gmaxdragon/Modular-Pi-Hat/BOM.md

# Modular PI HAT – bill of materials

<!-- Generated by Half Life from project cmuxmr025006j01ng1djt318e. Edits here are overwritten on the next sync. -->
<!-- Generated: 2026-10-12T02:13:04.104Z -->

> [!NOTE]
> This parts list is mirrored from [Half Life](https://halflife.hackclub.com). Editing it here will not change the platform's copy, and the next sync overwrites this file.

| Week | Tier | Parts funding |
| --- | --- | --- |
| Week 1 | Tier 3 | $100.00 |

| Part | What it's for | Qty | Unit | Total | Vendor |
| --- | --- | --- | --- | --- | --- |
| [ESP32-S3-WROOM-1-N8R8 module, 8MB flash + 8MB PSRAM](https://www.mouser.com/en/ProductDetail/Espressif-Systems/ESP32-S3-WROOM-1-N8R8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) | MAIN U2. Exact manufacturer part ESP32-S3-WROOM-1-N8R8: 8MB flash, 8MB PSRAM and PCB antenna. Mouser ordering number 356-EP32S3WROOM1N8R8. Purchase one bare SMD module from Mouser, not N8 or 1U varian | 1 | $6.28 | $6.28 | [Mouser](https://www.mouser.com/en/ProductDetail/Espressif-Systems/ESP32-S3-WROOM-1-N8R8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) |
| [AP2112K-3.3 3.3 V LDO regulator](https://www.digikey.com/en/products/detail/diodes-incorporated/AP2112K-3-3TRG1/4470746) | U3; verify thermal/load budget before making PCB or operating expansion ports. | 1 | $0.28 | $0.28 | [DigiKey](https://www.digikey.com/en/products/detail/diodes-incorporated/AP2112K-3-3TRG1/4470746) |
| [40-pin extra-tall 2x20 female stacking header](https://www.digikey.com/en/products/detail/adafruit-industries-llc/1979/6238003) | J1 bottom-side socket; verify actual bottom-mounting orientation, pin fit, Pi/Fusion HAT clearance. | 1 | $2.95 | $2.95 | [DigiKey](https://www.digikey.com/en/products/detail/adafruit-industries-llc/1979/6238003) |
| [4-way 5.08 mm Phoenix screw terminal](https://www.digikey.com/en/products/detail/phoenix-contact/1715747/260633) | One terminal on main J11 and one on extender J1. Verify housing/cable exit. | 2 | $2.28 | $4.56 | [DigiKey](https://www.digikey.com/en/products/detail/phoenix-contact/1715747/260633) |
| [2-way 5.08 mm Phoenix screw terminal](https://www.digikey.com/en/products/detail/phoenix-contact/1715721/260631) | J9 external servo power input. Verify exact terminal dimensions. | 1 | $1.16 | $1.16 | [DigiKey](https://www.digikey.com/en/products/detail/phoenix-contact/1715721/260631) |
| [Breakaway 0.1 inch male pin header strips, 10-pack](https://www.digikey.com/en/products/detail/adafruit-industries-llc/392/21283800) | Cut four 6-pin headers for MAIN J4 J5 J6 J7, five 3-pin headers for MAIN J2 J3 J12 and EXT J2 J3, plus four male pins for OLED; one ten-strip 36-pin pack covers all 43 physical pins. | 1 | $4.95 | $4.95 | [DigiKey](https://www.digikey.com/en/products/detail/adafruit-industries-llc/392/21283800) |
| [USB-C USB2.0 receptacle](https://www.digikey.com/en/products/detail/gct/USB4105-GF-A/11198441) | J8: custom land pattern; compare connector drawing and approve solderability. | 1 | $0.80 | $0.80 | [DigiKey](https://www.digikey.com/en/products/detail/gct/USB4105-GF-A/11198441) |
| [470 uF 10 V through-hole capacitor](https://www.digikey.com/en/products/detail/panasonic-industry/EEU-FR1A471/9921021) | C3; polarized. Match 8.0 mm body, 3.50 mm pitch, lead drill. | 1 | $0.71 | $0.71 | [DigiKey](https://www.digikey.com/en/products/detail/panasonic-industry/EEU-FR1A471/9921021) |
| [100 uF 25 V through-hole capacitor](https://www.digikey.com/en/products/detail/kyocera-avx/RPA0609101M025B/17634433) | C1; polarized. Extender actual footprint 6.3 mm body, 2.50 mm pitch. Verify lead and polarity. | 1 | $0.87 | $0.87 | [DigiKey](https://www.digikey.com/en/products/detail/kyocera-avx/RPA0609101M025B/17634433) |
| [22 uF 10 V 1206 ceramic capacitor](https://www.digikey.com/en/products/detail/samsung-electro-mechanics/CL31A226KPHNNNE/3886945) | C4; effective capacitance at 3.3 V bias pending. | 1 | $0.47 | $0.47 | [DigiKey](https://www.digikey.com/en/products/detail/samsung-electro-mechanics/CL31A226KPHNNNE/3886945) |
| [1 uF 50 V 0805 ceramic capacitor](https://www.digikey.com/en/products/detail/samsung-electro-mechanics/CL21A105KBCLNNC/3888054) | C2 C7 C8. | 3 | $0.18 | $0.54 | [DigiKey](https://www.digikey.com/en/products/detail/samsung-electro-mechanics/CL21A105KBCLNNC/3888054) |
| [100 nF 50 V 0805 ceramic capacitor](https://www.digikey.com/en/products/detail/samsung-electro-mechanics/CL21B104KBCNNNC/3886661) | C5 only; schematic C1 at bottom-left EEPROM is excluded from board. | 1 | $0.10 | $0.10 | [DigiKey](https://www.digikey.com/en/products/detail/samsung-electro-mechanics/CL21B104KBCNNNC/3886661) |
| [10k 1 percent 0805 resistor](https://www.digikey.com/en/products/detail/yageo/RC0805FR-0710KL/727535) | R3 R4 R12 R13. | 4 | $0.10 | $0.40 | [DigiKey](https://www.digikey.com/en/products/detail/yageo/RC0805FR-0710KL/727535) |
| [5.1k 1 percent 0805 resistor](https://www.digikey.com/en/products/detail/bourns-inc/CR0805-FX-5101ELF/4247942) | R5 R6; USB-C CC pull-downs. | 2 | $0.10 | $0.20 | [DigiKey](https://www.digikey.com/en/products/detail/bourns-inc/CR0805-FX-5101ELF/4247942) |
| [22 ohm 1 percent 0805 resistor](https://www.digikey.com/en/products/detail/yageo/RC0805FR-0722RL/727735) | R7 R8; USB data series resistors. | 2 | $0.10 | $0.20 | [DigiKey](https://www.digikey.com/en/products/detail/yageo/RC0805FR-0722RL/727735) |
| [1k 1 percent 0805 resistor](https://www.digikey.com/en/products/detail/yageo/RC0805FR-071KL/727444) | R9; indicator LED. | 1 | $0.10 | $0.10 | [DigiKey](https://www.digikey.com/en/products/detail/yageo/RC0805FR-071KL/727444) |
| [75k 1 percent 0805 resistor](https://www.digikey.com/en/products/detail/yageo/RC0805FR-0775KL/731080) | R10: replaces original 100k in USB VBUS sense divider. | 1 | $0.10 | $0.10 | [DigiKey](https://www.digikey.com/en/products/detail/yageo/RC0805FR-0775KL/731080) |
| [100k 1 percent 0805 resistor](https://www.digikey.com/en/products/detail/yageo/RC0805FR-07100KL/727544) | R11 only; R10 is now 75k. | 1 | $0.11 | $0.11 | [DigiKey](https://www.digikey.com/en/products/detail/yageo/RC0805FR-07100KL/727544) |
| [4.7k 1 percent 0805 resistor](https://www.digikey.com/en/products/detail/yageo/RC0805FR-074K7L/727929) | R14 R15; OLED I2C pullups. | 2 | $0.10 | $0.20 | [DigiKey](https://www.digikey.com/en/products/detail/yageo/RC0805FR-074K7L/727929) |
| [Green 0805 LED](https://www.digikey.com/en/products/detail/lite-on-inc/LTST-C170KGKT/386777) | D1; check cathode orientation. | 1 | $0.19 | $0.19 | [DigiKey](https://www.digikey.com/en/products/detail/lite-on-inc/LTST-C170KGKT/386777) |
| [SPST SMD tactile switch](https://www.digikey.com/en/products/detail/e-switch/TL3305AF160QG/5816181) | SW1 and RESET1; verify switch land pattern and orientation. | 2 | $0.21 | $0.42 | [DigiKey](https://www.digikey.com/en/products/detail/e-switch/TL3305AF160QG/5816181) |
| [Keystone mini blade through-hole fuse holder](https://www.digikey.com/en/products/detail/keystone-electronics/3568/2137306) | F1 Keystone holder DigiKey 36-3568-ND, designed for MINI 297 fuse; fuse purchased separately and already in DigiKey cart. | 1 | $1.31 | $1.31 | [DigiKey](https://www.digikey.com/en/products/detail/keystone-electronics/3568/2137306) |
| [Littelfuse MINI 297 2A 32V blade fuse, selected for prototype](https://www.digikey.com/en/products/detail/littelfuse-inc/0297002-WXNV/124900) | F1 blade fuse, DigiKey F986-ND. Keystone 3568 is MINI fuseholder; 2 A is provisional and must be checked against motor stall/load, source and wire before powering. | 1 | $0.39 | $0.39 | [DigiKey](https://www.digikey.com/en/products/detail/littelfuse-inc/0297002-WXNV/124900) |
| [0.91 inch white 128x32 SSD1306 I2C OLED breakout, DFRobot DFR0648](https://www.digikey.com/en/products/detail/dfrobot/DFR0648/12324932) | DigiKey 1738-DFR0648-ND, white 128x32 0.91 inch SSD1306 I2C; runs at 3.3V. Physical order SDA SCL GND VCC is NOT same as J10 GND 3V3 SCL SDA. NEVER plug directly into socket. Solder a four-pin male he | 1 | $9.90 | $9.90 | [DigiKey](https://www.digikey.com/en/products/detail/dfrobot/DFR0648/12324932) |
| [4-position 2.54mm Samtec OLED female socket](https://www.digikey.com/en/products/detail/samtec-inc/SSW-104-01-G-S/1112103) | J10; Samtec part 612-SSW-104-01-G-S-ND. Square-pin female 0.100 inch pitch; verify OLED male pin mating and body clearance. | 1 | $1.11 | $1.11 | [DigiKey](https://www.digikey.com/en/products/detail/samtec-inc/SSW-104-01-G-S/1112103) |
| [6 inch male-to-female jumper cable kit, 20 wires, for OLED J10 pin-order correction](https://www.digikey.com/en/products/detail/sparkfun-electronics/12794/5993859) | DigiKey 1568-12794-ND; 20 individual 6 inch jumper leads 28AWG. Use 4: male end to J10 Samtec female socket, female end to 4 soldered male OLED pins; map by signal labels, never directly insert OLED m | 1 | $2.75 | $2.75 | [DigiKey](https://www.digikey.com/en/products/detail/sparkfun-electronics/12794/5993859) |
| [Main PCB fabrication, 5 bare boards](https://jlcpcb.com/help/article/how-do-i-place-an-order) | Gerber/drill ZIP exists in fabrication/main/Seizo_Main_HAT_Gerbers.zip. $2 for 5 bare boards is a placeholder, NOT a quote; shipping/tax extra and pre-order hardware validation still required. | 1 | $4.00 | $4.00 | [JLCPCB](https://jlcpcb.com/help/article/how-do-i-place-an-order) |
| [Servo extender PCB fabrication, 5 bare boards](https://jlcpcb.com/help/article/how-do-i-place-an-order) | Gerber/drill ZIP exists in fabrication/servo-extender/Seizo_Servo_Extender_Gerbers.zip. Separate board fabrication order; $2 is placeholder, NOT a quote. Shipping/tax extra. | 1 | $4.00 | $4.00 | [JLCPCB](https://jlcpcb.com/help/article/how-do-i-place-an-order) |
| **Parts subtotal** | — | — | — | **$49.05** | — |
| **Tax & shipping** | — | — | — | **$30.00** | — |
| **Total** | — | — | — | **$79.05** | — |

$20.95 left of the tier's funding.
