gmaxdragon/Modular-Pi-Hat/purchasing/Seizo_DigiKey_ADD_ONLY_20_missing.csv

Part Number | Quantity | Customer Reference
5407-ESP32-S3-WROOM-1-N8R8CT-ND | 1 | MAIN U2 exact N8R8 - confirm stock in cart
AP2112K-3.3TRG1DICT-ND | 1 | MAIN U3 3.3V regulator CUT TAPE
1528-1783-ND | 1 | MAIN J1 Adafruit 1979 tall 40pin Pi socket
1528-392-ND | 1 | MAIN EXT breakaway male headers 10x36 pin pack
2073-USB4105-GF-ACT-ND | 1 | MAIN J8 USB C receptacle CUT TAPE
1276-1287-1-ND | 1 | MAIN C4 22uF 10V 1206 CUT TAPE
1276-2396-1-ND | 3 | MAIN C2 C7 C8 1uF 50V 0805 CUT TAPE
1276-1003-1-ND | 1 | MAIN C5 100nF 50V 0805 CUT TAPE
311-10.0KCRCT-ND | 4 | MAIN R3 R4 R12 R13 10k 0805 CUT TAPE
311-4.70KCRCT-ND | 2 | MAIN R14 R15 4.7k 0805 CUT TAPE
CR0805-FX-5101ELFCT-ND | 2 | MAIN R5 R6 5.1k 0805 USB CC CUT TAPE
311-22.0CRCT-ND | 2 | MAIN R7 R8 22 ohm 0805 USB data CUT TAPE
311-1.00KCRCT-ND | 1 | MAIN R9 1k 0805 LED CUT TAPE
311-75.0KCRCT-ND | 1 | MAIN R10 75k 0805 VBUS CUT TAPE
311-100KCRCT-ND | 1 | MAIN R11 100k 0805 VBUS CUT TAPE
160-1414-1-ND | 1 | MAIN D1 green LED 0805 CUT TAPE
EG5350CT-ND | 2 | MAIN SW1 RESET1 tact switches CUT TAPE
36-3568-ND | 1 | MAIN F1 Keystone 3568 MINI fuse holder
1738-DFR0648-ND | 1 | MAIN J10 0.91in 128x32 I2C OLED (wire via 4 individually mapped jumpers, NOT direct plug)
1568-12794-ND | 1 | MAIN J10 OLED 20x 6inch male-female jumper pack (use 4 to correct pin order)
