gmaxdragon/Modular-Pi-Hat/models/Ultimate_Pi_HAT_with_components.stl

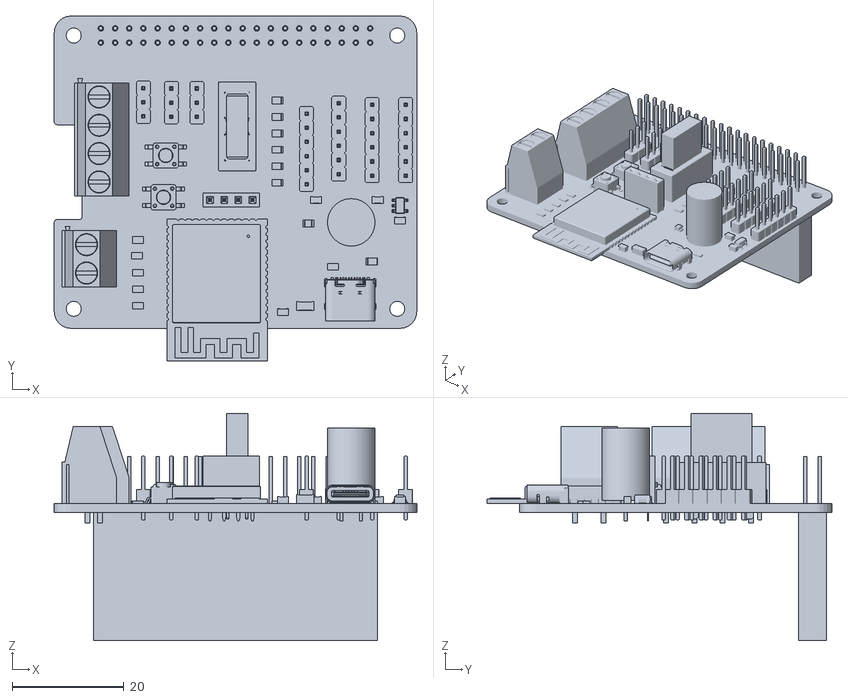
[picture p1: CAD file, 2026-11-10]
models/Ultimate_Pi_HAT_with_components.stl
65.0 x 61.8 x 40.8
