gmaxdragon/Modular-Pi-Hat/JOURNAL.md

# Modular PI HAT: devlog

<!-- Generated by Half Life from project cmuxmr025006j01ng1djt318e. Edits here are overwritten on the next sync. -->
<!-- Generated: 2026-11-10T05:49:47.541Z -->

> [!NOTE]
> This devlog is mirrored from [Half Life](https://halflife.hackclub.com) ([open the project](https://halflife.hackclub.com/projects/cmuxmr025006j01ng1djt318e)). Editing it here will not change the platform's copy, and the next sync overwrites this file.

> It's a massive PCB for my robotic arm which can handle 2 servos and multiple other parts with GPIO pins.

| Week | Tier | Hours logged | Entries |
| --- | --- | --- | --- |
| Week 1 | Tier 3 | 40h | 15 |

## Contents

1. [2026-10-07: I downloaded KiCad, used a template for a Pi HAT and an Esp32 S3 and worked a ton on it and mostly labeled things. I worked a ton on the boot and reset circuits with power buttons and stuff. It was re](#2026-10-07-i-downloaded-kicad-used-a-template-for-a-pi-hat-a)
2. [2026-10-07: I basically made the 16 GPIO ports, the 2 servo connectors for my arm, and added a chip for the usb ports. It looks massive but I'm sure I will be done soon. It's completely possible. The wiring took](#2026-10-07-i-basically-made-the-16-gpio-ports-the-2-servo-co)
3. [2026-10-08: Lots of changes happened, I realized that it's the schematic not the pcb, I learned and tested lots of things, I changed the power distribution to go through different traces for safety, I added a fus](#2026-10-08-lots-of-changes-happened-i-realized-that-its-the-)
4. [2026-10-08: I ran a lot of checks and KiCad's built in electronics checker and I found out all the errors as at first I had 30 errors and now there's none after hunting down all of the errors, I assigned footprin](#2026-10-08-i-ran-a-lot-of-checks-and-kicads-built-in-electro)
5. [2026-10-09: I finished the mini-pcb and fully routed it, learned the ways to change the size of wires, and did tons of things to make it look good and be fully functional! I finished my first PCB! Now just to wor](#2026-10-09-i-finished-the-mini-pcb-and-fully-routed-it-learn)
6. [2026-10-10: When I tried to import the big PCB now, it kept on  finding errors, even in the ERC. I had to work a ton to find all the errors, unconnected labels, clicking do not populate for some parts, and workin](#2026-10-10-when-i-tried-to-import-the-big-pcb-now-it-kept-on)
7. [2026-10-10: I worked extremely hard for this chunk. I fixed the schematics for the whole board, I edited tons of things like the wiring for the board, redid the whole 5V power system and added a tiny port for an](#2026-10-10-i-worked-extremely-hard-for-this-chunk-i-fixed-th)
8. [2026-10-11: There was an absolutely absurd amount of errors in the DRC I ran. At first it was 36 because of interference with the Silkscreen but then I tried adjusting locations and eventually adding a big wall o](#2026-10-11-there-was-an-absolutely-absurd-amount-of-errors-i)
9. [2026-10-11: I found and fixed a ton of warnings in the DRC about the footprints. I had to change pretty much every footprint as I added it wrong and I finally figured it out. Also I had to add some labels on the](#2026-10-11-i-found-and-fixed-a-ton-of-warnings-in-the-drc-ab)
10. [2026-10-11: I worked a ton on some final checks and making sure everything is good. I almost sent it to the PCB manufacturers with some errors in it such as the labels, the routing had some mistakes with the visa](#2026-10-11-i-worked-a-ton-on-some-final-checks-and-making-su)
11. [2026-10-11: Welp, I found some more errors. I started thinking more about the manufacturers and how accurate it would be so I had to move some of the vias to make it safer and not cause an explosion or something](#2026-10-11-welp-i-found-some-more-errors-i-started-thinking-)
12. [2026-10-11: I realized I hadn't picked a fuse yet. And logging the stuff for checkout required me to change some stuff and edit it quite a bit. It took forever to make the csv for the checkout and the BOM but ala](#2026-10-11-i-realized-i-hadnt-picked-a-fuse-yet-and-logging-)
13. [2026-10-21: I swapped the 3.3V regulator for a R-78B3.3 for safer voltage control and ease to solder, I added an ESD chip for the safety of the USB-C, I added no-connect markers to everything, fine-tuned the ERC,](#2026-10-21-i-swapped-the-33v-regulator-for-a-r-78b33-for-saf)
14. [2026-11-09: I coded the firmware for the board. I had to refer back to my old PCB and discuss with my coding expert friend and coded a test for the board. I also used AI to check the coding and help me with a bit](#2026-11-09-i-coded-the-firmware-for-the-board-i-had-to-refer)
15. [2026-11-10: I cadded out a full enclosure for the PCB and the Pi itselfwhich looks really cool. I know I used tinkercad, but I cannot cad with onshape as I am supposed to as tinkercad comes way easier to me too.](#2026-11-10-i-cadded-out-a-full-enclosure-for-the-pcb-and-the)

## Design

### 2026-10-07: I downloaded KiCad, used a template for a Pi HAT and an Esp32 S3 and worked a ton on it and mostly labeled things. I worked a ton on the boot and reset circuits with power buttons and stuff. It was re

**1h**

I downloaded KiCad, used a template for a Pi HAT and an Esp32 S3 and worked a ton on it and mostly labeled things. I worked a ton on the boot and reset circuits with power buttons and stuff. It was really cool. I think I'm doing good and soon enough I will be done, slowly but surely. I also labeled the TX and RX for connecting the ESP32 S3 to the Pi.





### 2026-10-07: I basically made the 16 GPIO ports, the 2 servo connectors for my arm, and added a chip for the usb ports. It looks massive but I'm sure I will be done soon. It's completely possible. The wiring took

**2h**

I basically made the 16 GPIO ports, the 2 servo connectors for my arm, and added a chip for the usb ports. It looks massive but I'm sure I will be done soon. It's completely possible. The wiring took forever though. Writing the name of the labels takes so long! Thank goodness KiCad has a feature where you just have to write the name and it automatically connects it. Routing it will take FOREVER though.





### 2026-10-08: Lots of changes happened, I realized that it's the schematic not the pcb, I learned and tested lots of things, I changed the power distribution to go through different traces for safety, I added a fus

**2.5h**

Lots of changes happened, I realized that it's the schematic not the pcb, I learned and tested lots of things, I changed the power distribution to go through different traces for safety, I added a fuse and some capacitors for safety, and I am almost done with the PCB.









### 2026-10-08: I ran a lot of checks and KiCad's built in electronics checker and I found out all the errors as at first I had 30 errors and now there's none after hunting down all of the errors, I assigned footprin

**2.5h**

I ran a lot of checks and KiCad's built in electronics checker and I found out all the errors as at first I had 30 errors and now there's none after hunting down all of the errors, I assigned footprints to all of the parts, I fixed the previous USB errors and the voltage regulators, I fixed the buttons, and the PI connectors. I'm planning on having a mini-pcb too for the 2 servos at the very front of my arm. I'll try to make that first in order to learn how to route and design these things! It's extremely fun! Thank you so much for this!







### 2026-10-09: I finished the mini-pcb and fully routed it, learned the ways to change the size of wires, and did tons of things to make it look good and be fully functional! I finished my first PCB! Now just to wor

**2h**

I finished the mini-pcb and fully routed it, learned the ways to change the size of wires, and did tons of things to make it look good and be fully functional! I finished my first PCB! Now just to work on the main thing...





### 2026-10-10: When I tried to import the big PCB now, it kept on  finding errors, even in the ERC. I had to work a ton to find all the errors, unconnected labels, clicking do not populate for some parts, and workin

**2h**

When I tried to import the big PCB now, it kept on  finding errors, even in the ERC. I had to work a ton to find all the errors, unconnected labels, clicking do not populate for some parts, and working a ton! At least now it's fixed and I can import the pcb. now just to organize it and route it! Maybe add some more cool things to it too...





### 2026-10-10: I worked extremely hard for this chunk. I fixed the schematics for the whole board, I edited tons of things like the wiring for the board, redid the whole 5V power system and added a tiny port for an

**3h**

I worked extremely hard for this chunk. I fixed the schematics for the whole board, I edited tons of things like the wiring for the board, redid the whole 5V power system and added a tiny port for an lcd screen that's 0.96 inches wide. I'm currently fixing the PCB more and routed everything. This took so long!







### 2026-10-11: There was an absolutely absurd amount of errors in the DRC I ran. At first it was 36 because of interference with the Silkscreen but then I tried adjusting locations and eventually adding a big wall o

**3h**

There was an absolutely absurd amount of errors in the DRC I ran. At first it was 36 because of interference with the Silkscreen but then I tried adjusting locations and eventually adding a big wall or blob of GND all over the board in B.Cu and then in F.Cu for 5V and then I did it wrong as I put it in a tiny section of the area that wasn't filled in and I messed it up and there was 79 errors. It was all caused by interference with the mounting holes and the design itself and the wires being too thin and thick and tons of other errors. This was extremely annoying but at least I learned a ton from it. I'm still actively working on the PCB though. It's almost done!!! I just need to check it further and maybe label it a bit more.







### 2026-10-11: I found and fixed a ton of warnings in the DRC about the footprints. I had to change pretty much every footprint as I added it wrong and I finally figured it out. Also I had to add some labels on the

**2h**

I found and fixed a ton of warnings in the DRC about the footprints. I had to change pretty much every footprint as I added it wrong and I finally figured it out. Also I had to add some labels on the back too. I am almost done! Just the documentation is left. Also, I modified the tiny servo controller too to have labels. There's a few errors in the ERC but that's because of the pins only connecting to one thing on the stacking header.  It's good now!





### 2026-10-11: I worked a ton on some final checks and making sure everything is good. I almost sent it to the PCB manufacturers with some errors in it such as the labels, the routing had some mistakes with the visa

**4h**

I worked a ton on some final checks and making sure everything is good. I almost sent it to the PCB manufacturers with some errors in it such as the labels, the routing had some mistakes with the visas touching each other, and a few more organizational errors too. I didn't notice this but one of the vias were touching the capacitor I think so I had to move some also. I think it's ready to submit.









### 2026-10-11: Welp, I found some more errors. I started thinking more about the manufacturers and how accurate it would be so I had to move some of the vias to make it safer and not cause an explosion or something

**2h**

Welp, I found some more errors. I started thinking more about the manufacturers and how accurate it would be so I had to move some of the vias to make it safer and not cause an explosion or something and actually make it work. Thank you so much for this whole experience and the funding!





### 2026-10-11: I realized I hadn't picked a fuse yet. And logging the stuff for checkout required me to change some stuff and edit it quite a bit. It took forever to make the csv for the checkout and the BOM but ala

**3h**

I realized I hadn't picked a fuse yet. And logging the stuff for checkout required me to change some stuff and edit it quite a bit. It took forever to make the csv for the checkout and the BOM but alas I finished it! I'm going to submit it right now. Also for the ESP32 from DigiKey it would arrive in April 2027 so I had to research for more sites.

![Screenshot 2026-10



-11 192128](https://halflife.hackclub-assets.com/sessions/1cjBC8H80sSoyKk4EDv7XmS5Kk83ydwd/c96d5625cdef4f93a260da83610962900fd2ac6ef16cafb1dba7fab7a72d5530.png)





### 2026-10-21: I swapped the 3.3V regulator for a R-78B3.3 for safer voltage control and ease to solder, I added an ESD chip for the safety of the USB-C, I added no-connect markers to everything, fine-tuned the ERC,

**6h**

I swapped the 3.3V regulator for a R-78B3.3 for safer voltage control and ease to solder, I added an ESD chip for the safety of the USB-C, I added no-connect markers to everything, fine-tuned the ERC, added a ton of more resistors for safety, resistor bridges, a few diodes, added footprints to everything, and now I think it's ready for making into an actual PCB.  I worked so much on this and I'm so tired now. I'm just glad I can have this funding and be able to learn and work on this.












## Build

### 2026-11-09: I coded the firmware for the board. I had to refer back to my old PCB and discuss with my coding expert friend and coded a test for the board. I also used AI to check the coding and help me with a bit

**3h**

I coded the firmware for the board. I had to refer back to my old PCB and discuss with my coding expert friend and coded a test for the board. I also used AI to check the coding and help me with a bit of it. Also, I verified it if it works in arduino ide and it does thankfully. It compiled correctly but I'm not sure if it will actually work though.







### 2026-11-10: I cadded out a full enclosure for the PCB and the Pi itselfwhich looks really cool. I know I used tinkercad, but I cannot cad with onshape as I am supposed to as tinkercad comes way easier to me too.

**2h**

I cadded out a full enclosure for the PCB and the Pi itselfwhich looks really cool. I know I used tinkercad, but I cannot cad with onshape as I am supposed to as tinkercad comes way easier to me too. I cadded out a slot for the PI, holes for all the wires and connectors, and I tried to accurately make the PCB fit too using the pcb that I made. Making the holes for where the components was hard to  do accurately but I tried my best.
