gmaxdragon/Modular-Pi-Hat/hardware/extender/SZSERVOEXTENDER.kicad_pcb

## KiCad design hardware/extender/SZSERVOEXTENDER.kicad_pcb (2026-10-11)

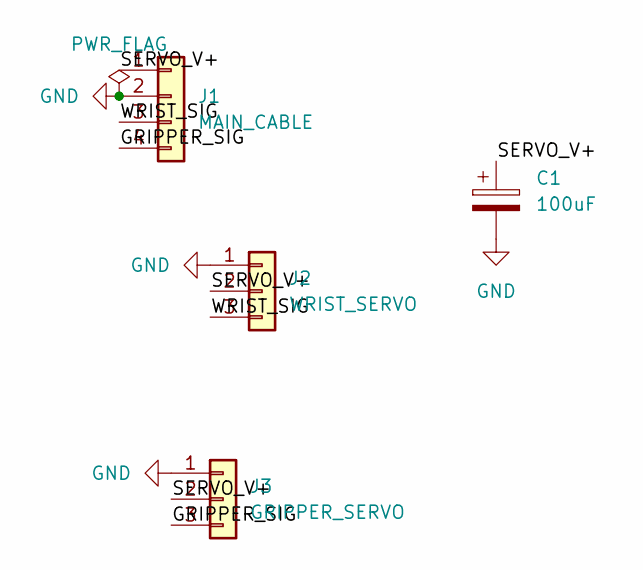
[picture p3: schematic SZSERVOEXTENDER.kicad_sch]

Parts:
C1: 100uF; CP_Radial_D6.3mm_P2.50mm
J1: MAIN_CABLE; TerminalBlock_Phoenix_MKDS-1,5-4-5.08_1x04_P5.08mm_Horizont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
J2: WRIST_SERVO; PinHeader_1x03_P2.54mm_Vertical
J3: GRIPPER_SERVO; PinHeader_1x03_P2.54mm_Vertical

Connections:
/GRIPPER_SIG: J1.4, J3.3
/SERVO_V+: C1.1, J1.1, J2.2, J3.2
/WRIST_SIG: J1.3, J2.3
GND: C1.2, J1.2, J2.1, J3.1

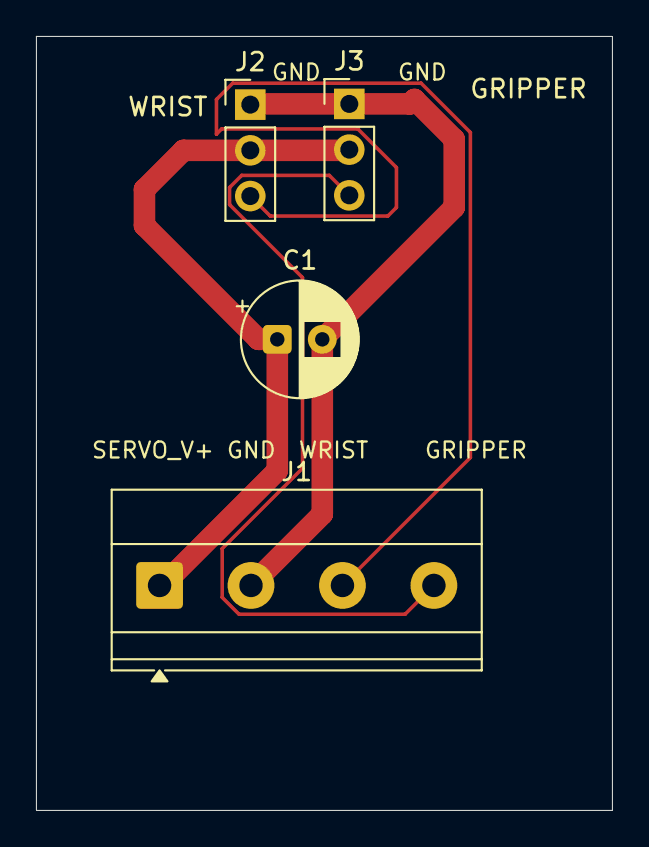
[picture p4: board SZSERVOEXTENDER.kicad_pcb from above]

Board: 2 copper layers, 32.0 x 43.0 mm, 4 parts (0 on the bottom side), 4 nets.
