gmaxdragon/Modular-Pi-Hat/(commit log)

2026-10-07 Sync 8-Handled PCB from Half Life
2026-10-07 Set seven-port USB connector requirement
2026-10-07 Lock Grade 4 connector choices
2026-10-07 Lock eight-port USB and connector choices
2026-10-09 Add sourced draft procurement BOM for the main HAT and servo extender
    [bom.csv]
2026-10-09 Add USB-only ESP32-S3 diagnostic firmware without motor-control outputs
2026-10-09 Document Seizo scope, project images, sourced BOM, diagnostic firmware and remaining build checks
2026-10-11 Add original KiCad source designs for Seizo main HAT and servo extender
2026-10-11 Include exact custom KiCad footprints for Seizo HAT
2026-10-11 Reconcile Half Life BOM to both Seizo KiCad designs and Tier 3 budget
2026-10-11 Document native KiCad files, current Tier 3 budget and design-stage limitations
2026-10-11 Switch exact ESP32-S3 N8R8 module sourcing to in-stock Mouser listing
2026-10-11 BOM: select 2A MINI fuse and remove backordered ESP32 from purchase list
2026-10-11 Reconcile Tier 2 BOM, correct OLED socket and include selected MINI fuse; defer backordered ESP32
2026-10-11 Add DigiKey cut-tape import for 17 missing items; avoid duplicating six cart items
2026-10-11 Document Tier 2 cart reconciliation, provisional fuse and remaining buying constraints
2026-10-11 Correct Tier 2 BOM: DigiKey OLED, jumper adapter, fuse and no backordered ESP32
2026-10-11 Add board-derived Seizo BOM with 2A fuse, deferred ESP32 and sourcing flags
2026-10-11 Add both verified Seizo native KiCad PCB and schematic designs
2026-10-11 Finalize BOM with fuse holder, 2A fuse, OLED cable and deferred ESP32
2026-10-11 Add direct DigiKey bulk upload for both Seizo boards with cut-tape SKUs
2026-10-11 Add precise separate main/extender Gerber and drill export instructions with hardware cautions
2026-10-11 Correct Tier 2 BOM to $38.75 and link complete 25-line DigiKey cart with OLED pinout safety
2026-10-11 Update Tier 2 purchasing: 19 missing/25 total lines, $38.75 and OLED/fuse safety guidance
2026-10-11 Reconcile exact DigiKey retailer for Pi stacking header in complete Tier 2 BOM
2026-10-11 Correct 1uF 0805 cut-tape price from verified DigiKey listing
2026-10-11 Remove superseded DigiKey cart list; current 19/25-line list replaces it
2026-10-11 Itemize all 43 breakaway header pins across both boards and OLED
2026-10-11 Automate KiCad 10 Gerber and drill exports for both unchanged boards
2026-10-11 Fix KiCad Gerber export directory write permissions
2026-10-11 Add KiCad 10 Gerber and Excellon drill archives for Seizo boards
2026-10-11 Complete Tier 2 purchase CSV with actual ESP32-S3 N8R8 module
2026-10-11 Document committed KiCad 10 Gerber and drill exports for both boards
2026-10-11 Update Seizo README for verified Gerber archives and complete Tier 2 CSV
2026-10-11 Synchronize Tier 2 purchasing notes with complete CSV and Gerber exports
2026-10-11 Correct Tier 2 remaining budget arithmetic in README (no PCB changes)
2026-10-11 Add main Seizo HAT and servo extender KiCad PCB source files
2026-10-12 Reconcile Seizo $45.09 BOM and preserve exact N8R8 with sourcing alternatives
2026-10-12 Update Seizo README with 26-part cart and exact ESP32 fallback sourcing
2026-10-12 Correct Seizo ordering SKU, component prices and ESP32 required status
2026-10-12 Switch required ESP32 to Mouser and correct 28-line engineering BOM
2026-10-12 Document Mouser-sourced ESP32 and 25-item DigiKey checkout for Half Life
2026-10-22 Format current Week 1 BOM.csv as README table; leave project narrative for author rewrite
2026-10-22 Use Vivaan's verbatim Week 1 explanation and journal note; show $4 per PCB
2026-10-22 Correct fabrication quantities to one main PCB and one extender at $4 each
2026-10-22 Reconcile engineering BOM with confirmed $4 per-board fabrication cost
2026-10-22 Align Week 1 purchasing totals with $4 per PCB; preserve assembly cautions
2026-10-25 Capture unpriced HAT assembly and fabrication items
2026-11-10 Fix ESP32 core BOOT_PIN name collision after Arduino Verify
2026-11-10 Add component STL and enclosure fitting assumptions
